gneiss15/AquariumControl/FeederSimple/Hw/README.DE.md

# FeederSimple – Hardware

[English](README.md)

**Coming soon – unvollständig.** FeederSimple ist der Umbau eines gekauften Futterautomaten. Die Originalsteuerung wird ersetzt; die vorhandene Platine und Mechanik werden weiterverwendet. Bestätigte Signalbelegungen und aktuelle Firmwarevorgaben stehen in der [Projekt-README](../README.DE.md).

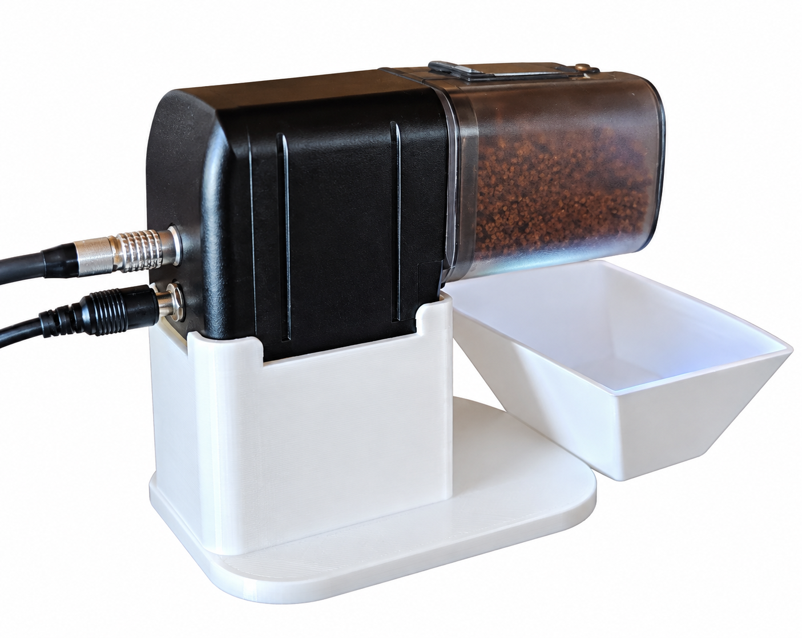
[picture p1: FeederSimple/Hw/Images/FeederComplete.png]
Umgebauter Futterautomat


Noch zu ergänzen: genaue Bezeichnung des Ausgangsgeräts, vollständige Verkabelung, Stückliste, Umbau- und Montageschritte sowie verwendete CAD-/STL-Unterlagen.
