gneiss15/AquariumControl/MultiTimer/Hw/README.DE.md

# MultiTimer / Dashboard – Raspberry-Pi-Hardware

[English](README.md)

**Coming soon – unvollständige Hardwarebeschreibung.** Der vorhandene Aufbau besteht aus einem Raspberry Pi 3 Model B, einer achtfachen Relaiskarte und einem Netzteil im Gehäuse eines Conrad IR-Powermanagers. MultiTimer und Dashboard laufen als getrennte Dienste auf demselben Pi. Ein zusätzlicher Dienst ist für den Raumtemperatur-Sensor vorgesehen; dessen Einbau und Funktionstest stehen noch aus. Der Akku-Sender läuft auf dem Laptop.

## Vorhandene Unterlagen

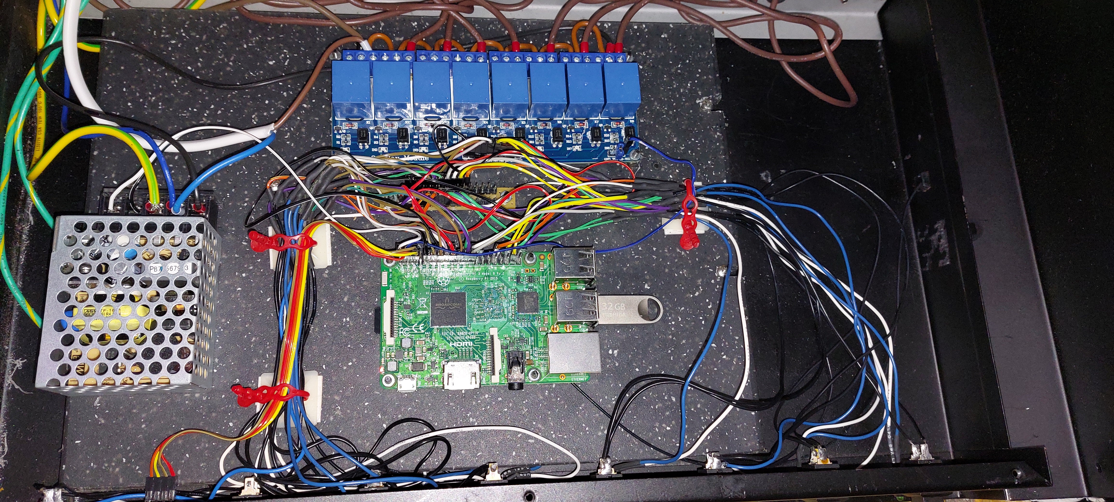
[picture p2: MultiTimer/Hw/Images/20261019_093540.jpg]
Raspberry Pi, relay board and power supply


Weitere Aufnahmen: [20261019_093611](Images/20261019_093611.jpg) · [20261019_093616](Images/20261019_093616.jpg) · [20261019_093928](Images/20261019_093928.jpg) · [20261019_094013](Images/20261019_094013.jpg)

Relaismodul-Unterlage (manufacturer reference; not bundled) · [Sensorplatte (STL)](CAD/SensorPlate.stl) · [Raumtemperatur-Sender](../../RoomTemperature/README.DE.md)

## Noch offen

Vollständige Stückliste mit Netzteil- und Relaiskarten-Typ, Anschlussplan, GPIO-/Kanal-/Steckdosenbelegung und Beschreibung von Einbau und Gehäuse. Die Fotos allein sind keine vollständige Bauanleitung.
