gneiss15/AquariumControl/TmrSwA8T/Hw/README.DE.md

<!-- README.DE.md, Version: 1.00 -->
# TmrSwA8T – Hardware

[English](README.md)

Dieses Projekt verwendet übernommene Nous-A8T-Steckdosen mit eigener Firmware. Die Gerätehardware ist ein Kaufprodukt. Das Verfahren zur Übernahme wird im separaten Projekt [ShellyNousTakeover](https://github.com/gneiss15/ShellyNousTakeover) beschrieben.

## Vorgesehene Ablage

- `Schematics/`: Schaltpläne, Anschluss- und Verdrahtungsunterlagen.
- `PCB/`: Platinenentwürfe und zugehörige Fertigungsdaten, soweit vorhanden.
- `Mechanics/`: CAD-Zeichnungen, Gehäuse- und Bauteilmodelle sowie STL-Dateien.

## Stand der Dokumentation

Die konkreten Dateien und ausführlichen Beschreibungen folgen noch. Bilder,
CAD-Daten, Materiallisten und Baubeschreibungen müssen noch zusammengestellt
bzw. erstellt werden; dies erfordert noch erheblichen Dokumentationsaufwand.
Die angelegten Unterverzeichnisse sind zunächst Platzhalter und bedeuten nicht,
dass für jedes Projekt eigene Platinen oder bereits vollständige Bauunterlagen vorliegen.

Die Hardwareunterlagen bleiben beim jeweiligen Projekt im selben Repository.
Vor Veröffentlichung der konkreten Dateien werden Herkunft und Nutzungsrechte geprüft.
