gneiss15/AquariumControl/TmrSwA8T/Hw/README.md

<!-- README.md, Version: 1.00 -->
# TmrSwA8T – hardware

[Deutsch](README.DE.md)

This project uses converted Nous A8T sockets with custom firmware. The hardware is a purchased product. Initial takeover is described in the separate [ShellyNousTakeover](https://github.com/gneiss15/ShellyNousTakeover) project.

## Directory layout

- `Schematics/`: circuit, connection and wiring documents.
- `PCB/`: PCB designs and manufacturing data, where available.
- `Mechanics/`: CAD drawings, enclosure/component models and STL files.

## Documentation status

Detailed files and descriptions will follow. Images, CAD data, bills of materials and assembly instructions still need to be collected or created. The directories are placeholders; their presence does not imply custom PCBs or complete construction documents.

Hardware documentation is kept with its project in the same repository. Sources and usage rights are checked before specific files are published.
