gneiss15/AquariumControl/FeederSimple/Hw/README.md

# FeederSimple – hardware

[Deutsch](README.DE.md)

**Coming soon – incomplete.** FeederSimple modifies a purchased feeder. The original controller is replaced; the existing PCB and mechanical parts are reused. Tested signal assignments and current firmware settings are documented in the [project README](../README.md).

Modified feeder

Still to document: original device model, complete wiring, bill of materials, modification and assembly steps, and any CAD/STL files used for the conversion.
