gneiss15/AquariumControl/MultiTimer/Hw/Images/20261019_093611.jpg

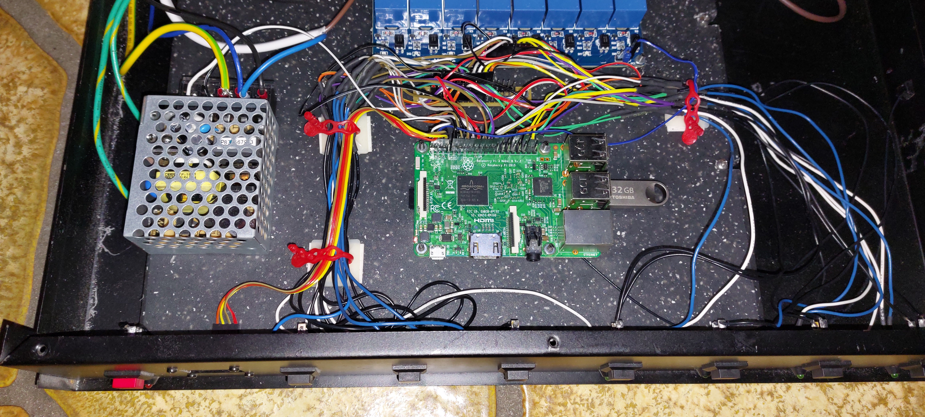
MultiTimer/Hw/Images/20261019_093611.jpg
