gneiss15/AquariumControl/MultiTimer/Hw/Images/20261019_093616.jpg

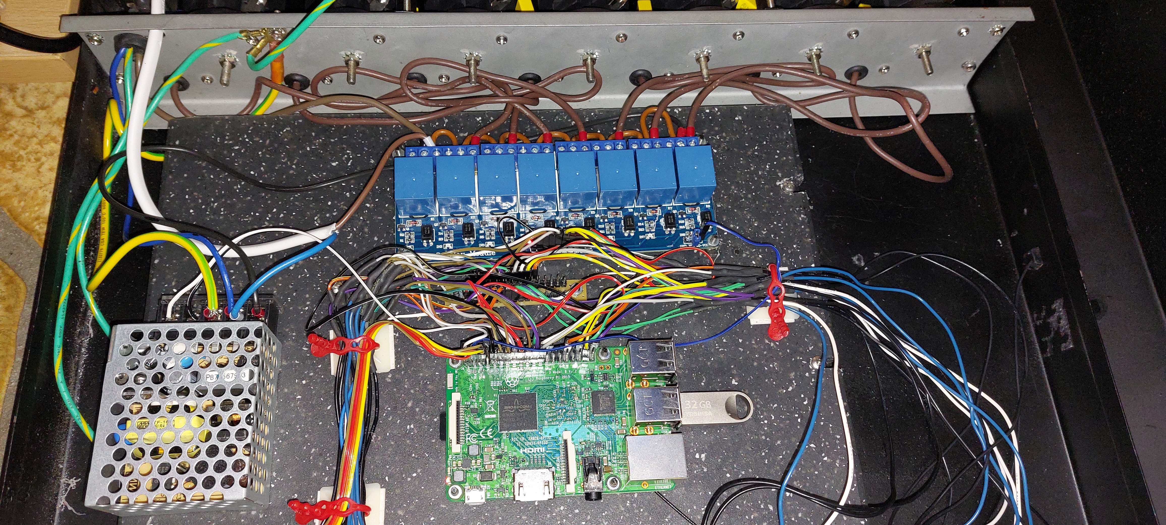
MultiTimer/Hw/Images/20261019_093616.jpg
