gneiss15/AquariumControl/MultiTimer/Hw/Images/20261019_094013.jpg

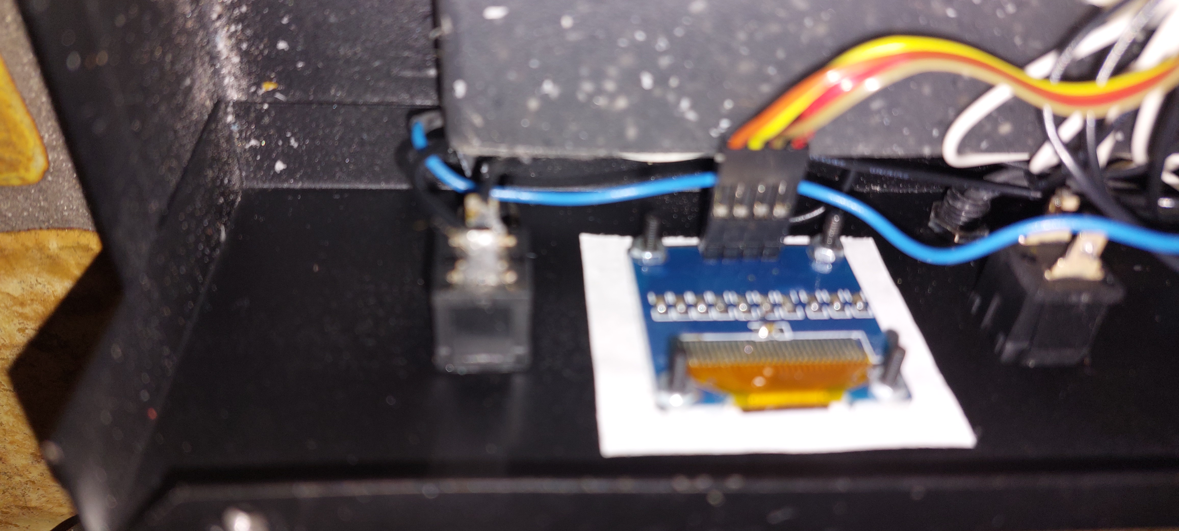
MultiTimer/Hw/Images/20261019_094013.jpg
