gneiss15/AquariumControl/Feeder/Hw/BOM.csv

Position | Quantity | CADLabel | Kind | Standard | Diameter | Length_mm | SourceObjects | AssemblyLinks | Description | Material | Manufacturer | PartNumber | Supplier | OrderURL | Unit | Notes
1 | 1 | CaseBot | Part |  |  |  | Body003004013 | Asm_CaseBot |  |  |  |  |  |  | pcs
2 | 1 | Bot | Part |  |  |  | Body003004011 | Asm_Bot |  |  |  |  |  |  | pcs
3 | 1 | Center | Part |  |  |  | Body | Asm_Center |  |  |  |  |  |  | pcs
4 | 1 | Top | Part |  |  |  | Body003004012 | Asm_Top |  |  |  |  |  |  | pcs
5 | 1 | Lid | Part |  |  |  | Body003004025 | Asm_Lid |  |  |  |  |  |  | pcs
6 | 1 | Funnel | Part |  |  |  | Body003004026 | Asm_Funnel |  |  |  |  |  |  | pcs
7 | 1 | Front | Part |  |  |  | Body003004042 | Asm_Front |  |  |  |  |  |  | pcs
8 | 1 | Food | Part |  |  |  | Body003004039 | Asm_Food |  |  |  |  |  |  | pcs
9 | 1 | WifiKit8 | Assembly |  |  |  | Part006 | Asm_WifiKit8 |  |  |  |  |  |  | pcs
10 | 1 | RotEnc | Assembly |  |  |  | Part007 | Asm_RotEnc |  |  |  |  |  |  | pcs
11 | 1 | DC-Jack | Assembly |  |  |  | Part005 | Asm_DC_Jack |  |  |  |  |  |  | pcs
12 | 1 | ServoPart | Assembly |  |  |  | Part | Asm_ServoPart |  |  |  |  |  |  | pcs
13 | 1 | Lemo-Socket | Assembly |  |  |  | _1 | Asm_Lemo_Socket |  |  |  |  |  |  | pcs
14 | 2 | Screw M2.5 x 5 | Fastener | ISO7045 | M2.5 | 5 | Screw008; Screw009 | Asm_M2_5x5_Screw; Asm_M2_5x5_Screw040 |  |  |  |  |  |  | pcs
15 | 2 | Screw M1.6 x 5 | Fastener | ISO7045 | M1.6 | 5 | Screw010; Screw011 | Asm_M1_6x5_Screw; Asm_M1_6x5_Screw003 |  |  |  |  |  |  | pcs
16 | 4 | Screw M2.5 x 12 | Fastener | ISO7045 | M2.5 | 12 | Screw012; Screw013; Screw014; Screw015 | Asm_M2_5x12_Screw; Asm_M2_5x12_Screw059; Asm_M2_5x12_Screw060; Asm_M2_5x12_Screw061 |  |  |  |  |  |  | pcs
17 | 1 | FrontBridge | Part |  |  |  | Body003004043 | Asm_FrontBridge |  |  |  |  |  |  | pcs
