gneiss15/AquariumControl/Feeder/Hw/CAD/FeederV2-Top.stl

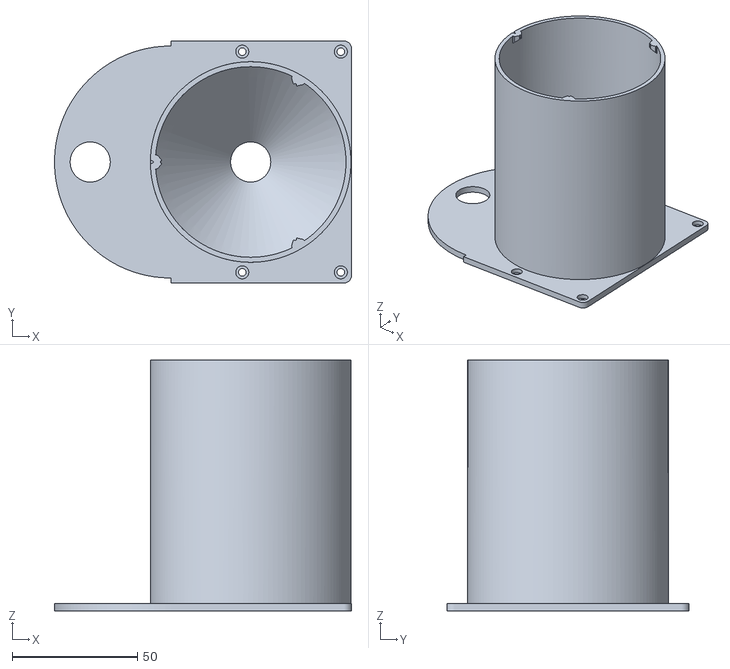
[picture p15: CAD file, 2026-10-21]
Feeder/Hw/CAD/FeederV2-Top.stl
118.4 x 96.5 x 100.0
