gneiss15/AquariumControl/FeederSimple/Hw/CAD/MCU_Holder.FCStd

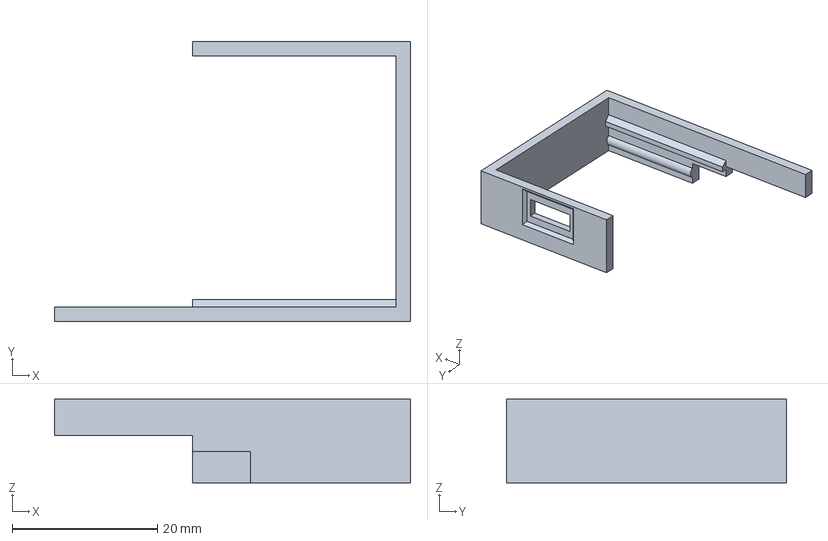
[picture p16: CAD file, 2026-10-20]
FeederSimple/Hw/CAD/MCU_Holder.FCStd
49.0 x 38.5 x 11.5 mm
