gneiss15/AquariumControl/MultiTimer/Hw/CAD/SensorPlate.FCStd

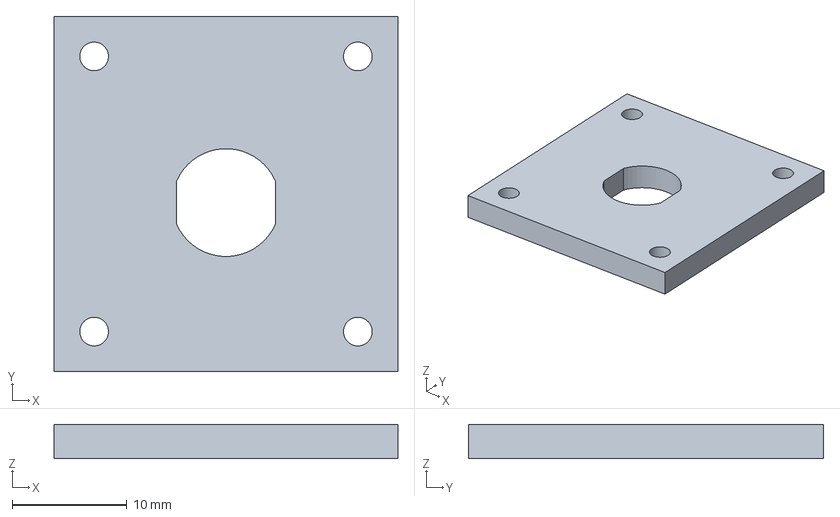
[picture p17: CAD file, 2026-11-11]
MultiTimer/Hw/CAD/SensorPlate.FCStd
30.0 x 31.0 x 3.00 mm
