gneiss15/AquariumControl/Feeder/Hw/CAD/Feeder-Lid.stl

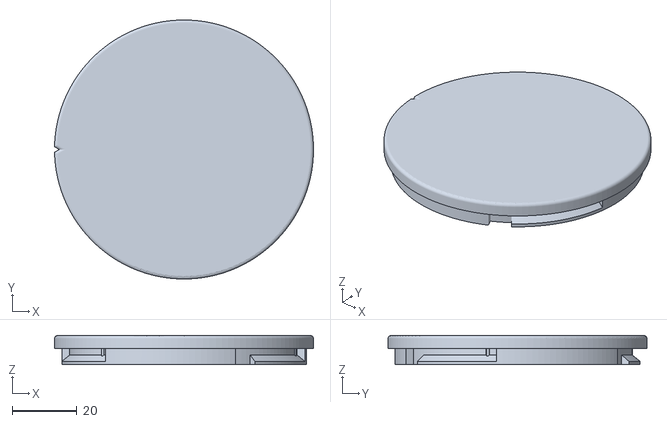
[picture p18: CAD file, 2026-10-21]
Feeder/Hw/CAD/Feeder-Lid.stl
80.0 x 80.0 x 9.00
