gneiss15/AquariumControl/Feeder/Hw/CAD/Feeder-Funnel.stl

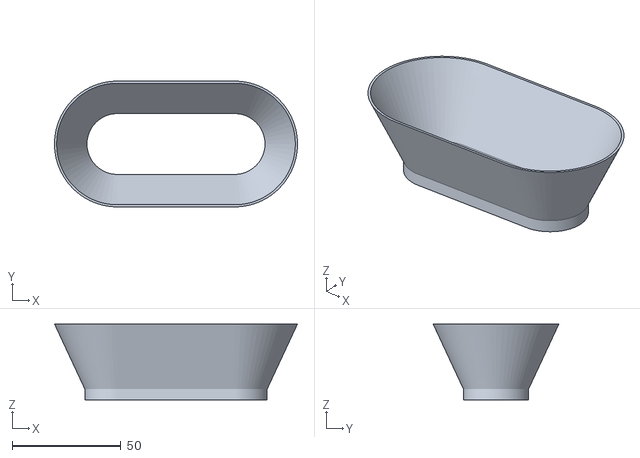
[picture p19: CAD file, 2026-10-21]
Feeder/Hw/CAD/Feeder-Funnel.stl
112.0 x 58.0 x 35.0
