gneiss15/AquariumControl/Feeder/Hw/CAD/Feeder-CaseBot.stl

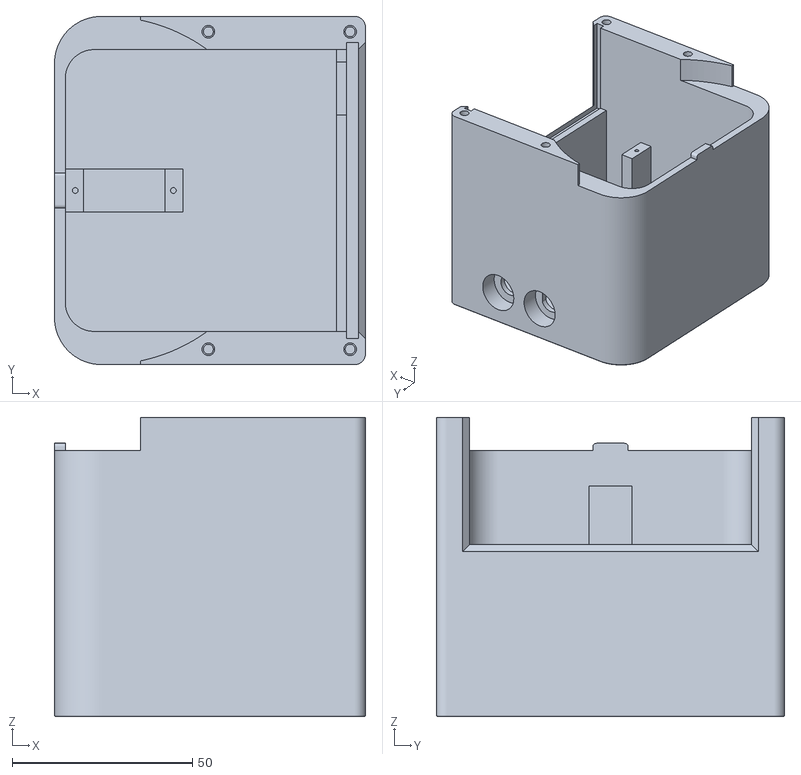
[picture p20: CAD file, 2026-10-21]
Feeder/Hw/CAD/Feeder-CaseBot.stl
86.2 x 96.5 x 83.0
