gneiss15/AquariumControl/Feeder/Hw/CAD/FeederV2.FCStd

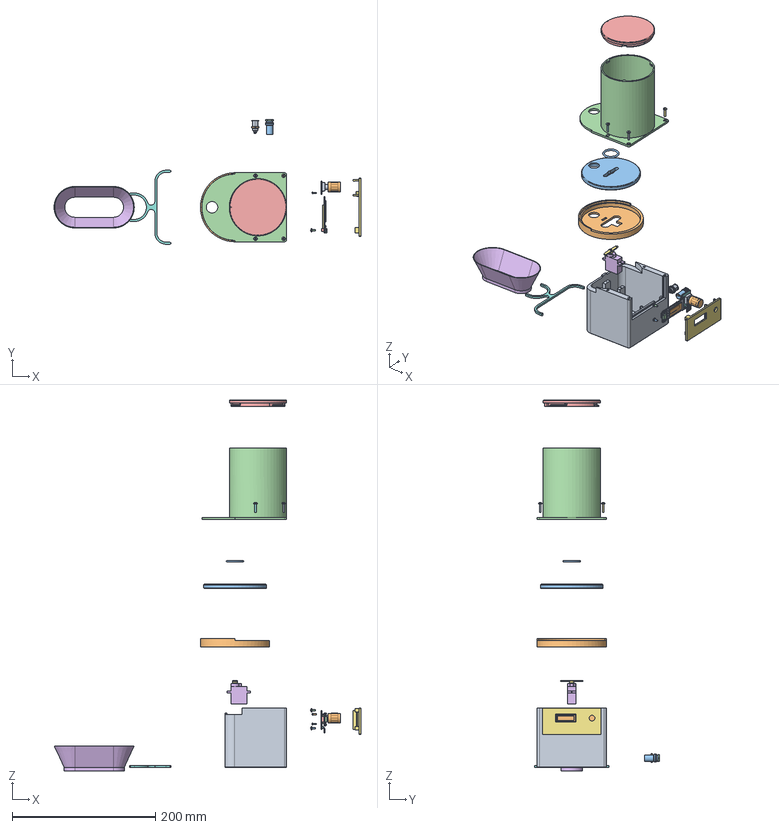
[picture p21: CAD file, 2026-10-21]
Feeder/Hw/CAD/FeederV2.FCStd
428.4 x 174.0 x 518.0 mm
CaseBot
Bot
Center
Top
Lid
Funnel
Front
Food
WifiKit8PCB
WifiKit8OLED
WifiKit8Taster
WifiKit8USB
WifiKit8BAT
WifiKit8IcsTop
WifiKit8IcsBot
RotEncPCB
RotEncBody
RotEncKnob
DC-Jack-Interior
DC-Jack-Nut
DC-Jack-SpringWasher
ServoBody
ServoHorn
ServoPinion
M2.5x5-Screw
M2.5x5-Screw053
M1.6x5-Screw
M2.5x12-Screw
M2.5x12-Screw221
M2.5x12-Screw222
M2.5x12-Screw223
M1.6x5-Screw009
