gneiss15/AquariumControl/Feeder/Hw/CAD/Feeder-Food.stl

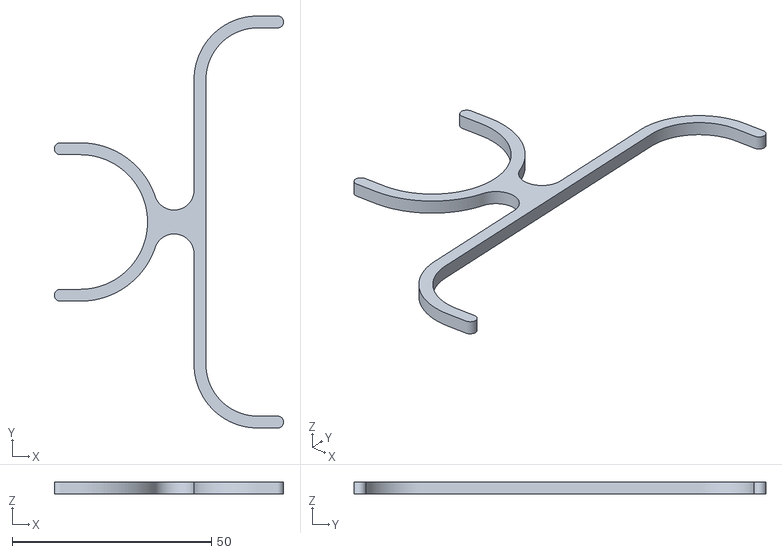
[picture p22: CAD file, 2026-10-21]
Feeder/Hw/CAD/Feeder-Food.stl
57.6 x 103.5 x 3.00
