gneiss15/AquariumControl/Feeder/Hw/CAD/Feeder-Bot.stl

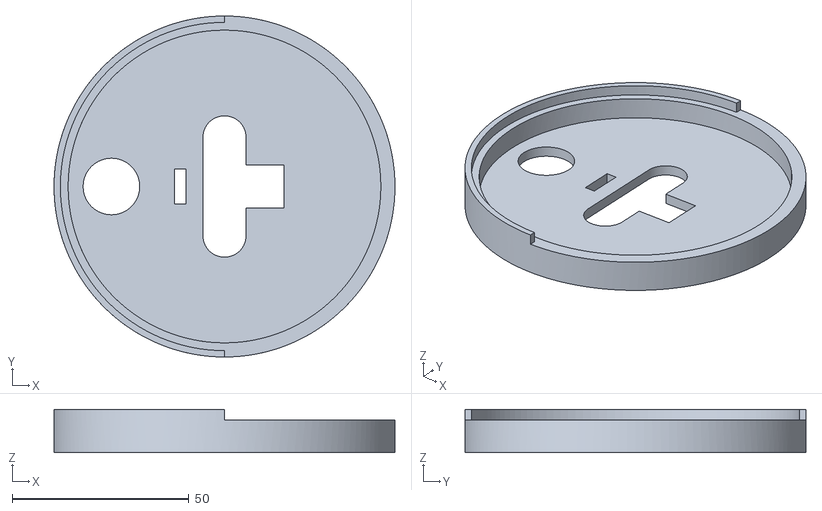
[picture p23: CAD file, 2026-10-21]
Feeder/Hw/CAD/Feeder-Bot.stl
96.5 x 96.5 x 12.2
