gneiss15/AquariumControl/Feeder/Hw/CAD/Feeder.FCStd

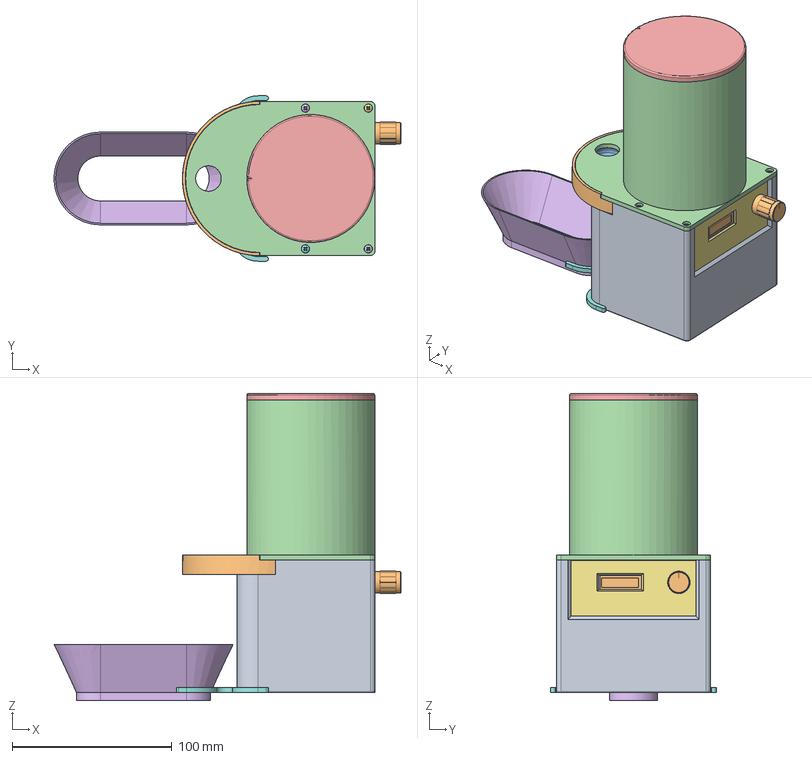
[picture p24: CAD file, 2026-10-21]
Feeder/Hw/CAD/Feeder.FCStd
217.0 x 103.5 x 192.0 mm
CaseBot
Bot
Center
Top
Lid
Funnel
Front
Food
WifiKit8PCB
WifiKit8OLED
WifiKit8Taster
WifiKit8USB
WifiKit8BAT
WifiKit8IcsTop
WifiKit8IcsBot
RotEncPCB
RotEncBody
RotEncKnob
DC-Jack-Interior
DC-Jack-Nut
DC-Jack-SpringWasher
ServoBody
ServoHorn
ServoPinion
M2.5x5-Screw
M2.5x5-Screw051
M1.6x5-Screw
M2.5x12-Screw
M2.5x12-Screw158
M2.5x12-Screw159
M2.5x12-Screw160
M1.6x5-Screw009
FrontBridge
