gneiss15/AquariumControl/Feeder/Hw/CAD/Feeder-Center.stl

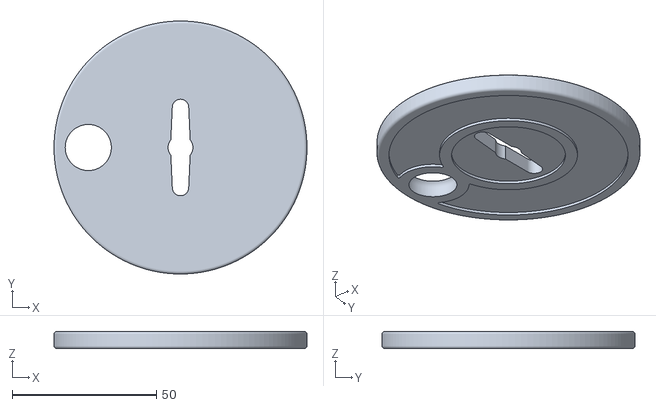
[picture p25: CAD file, 2026-10-21]
Feeder/Hw/CAD/Feeder-Center.stl
87.8 x 87.8 x 6.00
