gneiss15/AquariumControl/Feeder/Hw/CAD/Feeder-Top.stl

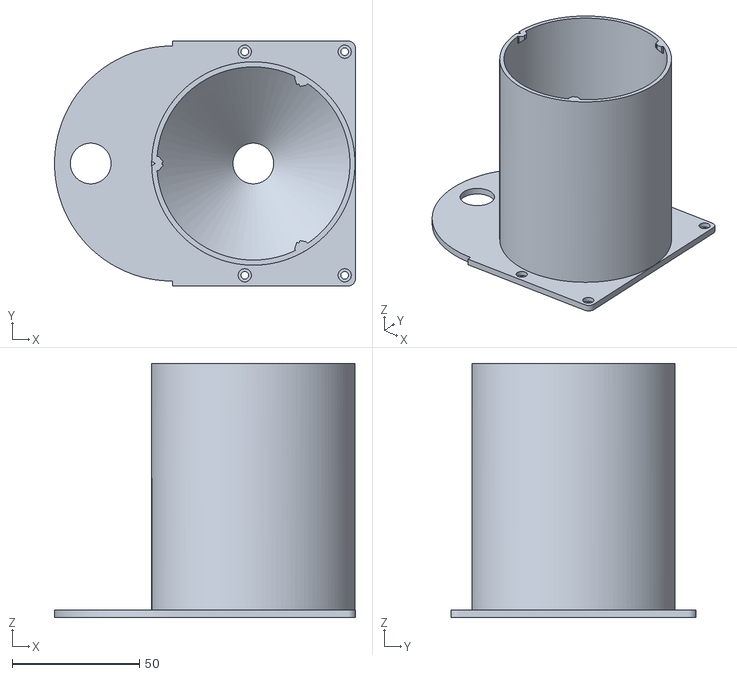
[picture p26: CAD file, 2026-10-21]
Feeder/Hw/CAD/Feeder-Top.stl
118.4 x 96.5 x 100.0
