gneiss15/AquariumControl/Feeder/Hw/CAD/Feeder-Front.stl

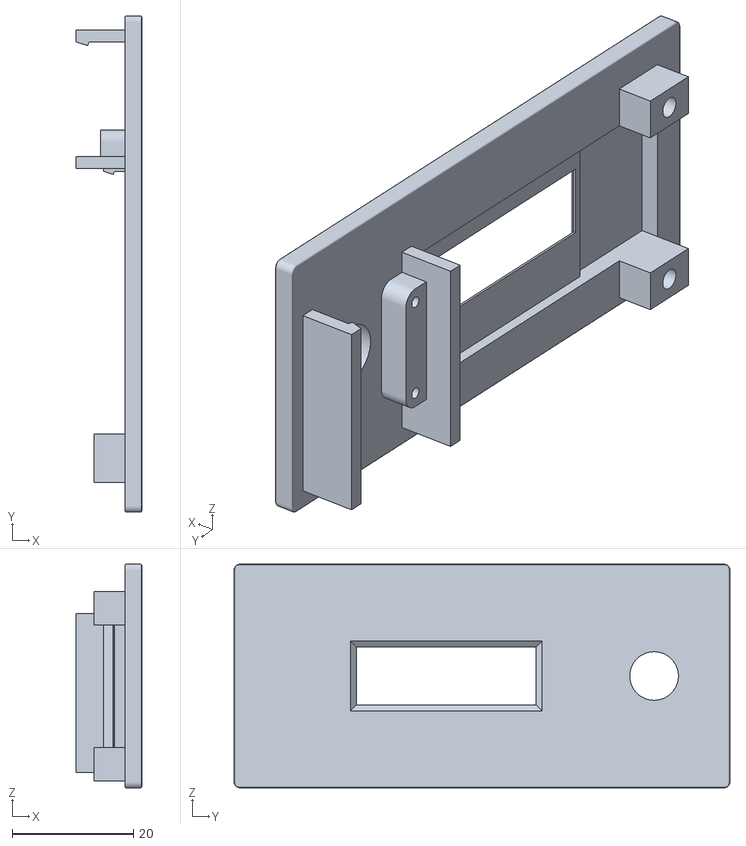
[picture p27: CAD file, 2026-10-20]
Feeder/Hw/CAD/Feeder-Front.stl
10.8 x 81.7 x 36.8
