gneiss15/AquariumControl/Feeder/Hw/CAD/Feeder-FrontBridge.stl

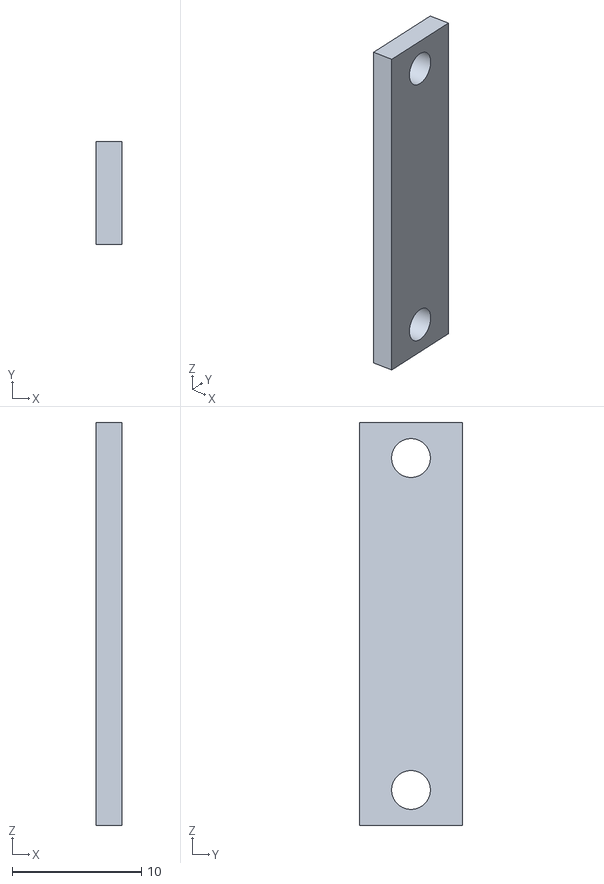
[picture p28: CAD file, 2026-10-20]
Feeder/Hw/CAD/Feeder-FrontBridge.stl
2.00 x 8.00 x 31.2
