gneiss15/AquariumControl/(list of files, cad)

Other CAD files:
FeederSimple/Hw/CAD/MCU_Holder.stl
MultiTimer/Hw/CAD/SensorPlate.3mf
MultiTimer/Hw/CAD/SensorPlate.stl
