gneiss15/AquariumControl/HeatHistory/Charts.html

App ?

# HeatHistory

RangeFromToLoadShow range

Water and Room share one temperature plot. All rows share the UTC time axis. All shows the available retained history, starting with PI activation. Energy totals cover the selected range; measurement gaps remain visible.

PI components explained

Proportional: Kp × (setpoint − water temperature). Integral: accumulated temperature error, limited against windup. Heat-loss estimate: estimated baseline from the heat-loss coefficient and room temperature. Total is the limited demand; Act is delivered power.

The chart library could not be loaded. An internet connection is required.
