gneiss15/AquariumControl/Common/EspRescue/EspRescueHardware.h

// EspRescueHardware.h, Version: 2.00
#pragma once

namespace EspRescueHardware
 {
constexpr int KeyPin = -1;
constexpr int KeyActiveLevel = LOW;
constexpr int StatusLedPin = -1;
constexpr int StatusLedActiveLevel = HIGH;
 }
