gneiss15/AquariumControl/TmrSwShelly/Sw/Rescue/EspRescueHardware.h

// EspRescueHardware.h, Version: 1.01
#pragma once
namespace EspRescueHardware
 {
constexpr int KeyPin = 7;
constexpr int KeyActiveLevel = LOW;
constexpr int StatusLedPin = 18;
constexpr int StatusLedActiveLevel = LOW;
 }
