gneiss15/AquariumControl/Common/EspRescue/EspRescueUpdater.cpp

// EspRescueUpdater.cpp, Version: 2.15
#include "EspRescueUpdater.h"
#include "DeviceType.inc.h"
#include "EspSignedArtifact.h"

#include <cerrno>
#include <cstdio>
#include <esp_err.h>
#include <cstring>
#include <fcntl.h>
#include <sys/time.h>
#include <unistd.h>

#include <esp_system.h>
#include <freertos/FreeRTOS.h>
#include <freertos/task.h>
#include <lwip/inet.h>
#include <lwip/sockets.h>

namespace
 {
  constexpr int HttpTimeoutSeconds = 10;

  bool VerifyWrittenPayload( const esp_partition_t * Partition,
    uint32_t PayloadSize, const uint8_t ExpectedHash[32] )
   {
    TEspSignedArtifactHash Hash;
    Hash.Begin();
    uint8_t Buffer[1024];
    for( uint32_t Offset = 0; Offset < PayloadSize; )
     {
      const size_t Count = PayloadSize - Offset < sizeof( Buffer ) ?
        PayloadSize - Offset : sizeof( Buffer );
      if( esp_partition_read( Partition, Offset, Buffer, Count ) != ESP_OK )
        return false;
      Hash.Add( Buffer, Count );
      Offset += Count;
     }
    return Hash.EndAndCompare( ExpectedHash );
   }

  bool IsContentLengthHeader( char const * Line )
   {
    constexpr char Name[] = "content-length:";
    for( size_t Index = 0; Index < sizeof( Name ) - 1; ++Index )
     {
      char Ch = Line[Index];
      if( Ch >= 'A' && Ch <= 'Z' )
        Ch += 'a' - 'A';
      if( Ch != Name[Index] )
        return false;
     }
    return true;
   }

  bool ParseUInt32( char const * Text, uint32_t & Value )
   {
    while( *Text == ' ' || *Text == '\t' )
      ++Text;
    if( *Text < '0' || *Text > '9' )
      return false;

    uint32_t Result = 0;
    while( *Text >= '0' && *Text <= '9' )
     {
      const uint32_t Digit = uint32_t( *Text - '0' );
      if( Result > (UINT32_MAX - Digit) / 10 )
        return false;
      Result = Result * 10 + Digit;
      ++Text;
     }
    Value = Result;
    return true;
   }

  char const * StatusLine( int Status )
   {
    switch( Status )
     {
      case 200: return "HTTP/1.1 200 OK\r\n";
      case 400: return "HTTP/1.1 400 Bad Request\r\n";
      case 409: return "HTTP/1.1 409 Conflict\r\n";
      case 404: return "HTTP/1.1 404 Not Found\r\n";
      case 411: return "HTTP/1.1 411 Length Required\r\n";
      default:  return "HTTP/1.1 500 Internal Server Error\r\n";
     }
   }
 }

TEspRescueUpdater::TEspRescueUpdater(void)
 : FServerSocket( -1 )
 , FProjectName( "ESP" )
 , FRescueVersion( "?" )
 , FMainPartition( nullptr )
 , FFileSystemPartition( nullptr )
 , FUpdateCompleted( false )
 {
 }

bool TEspRescueUpdater::Setup( char const * ProjectName,
  char const * RescueVersion )
 {
  FProjectName = ProjectName ? ProjectName : "ESP";
  FRescueVersion = RescueVersion ? RescueVersion : "?";
  FMainPartition = esp_partition_find_first(
    ESP_PARTITION_TYPE_APP, ESP_PARTITION_SUBTYPE_APP_OTA_0, nullptr );
  FFileSystemPartition = esp_partition_find_first(
    ESP_PARTITION_TYPE_DATA, ESP_PARTITION_SUBTYPE_DATA_SPIFFS, nullptr );

  // Once Rescue is running it stays the boot target until Commit succeeds.
  RestoreRescueBoot();

  FServerSocket = socket( AF_INET, SOCK_STREAM, IPPROTO_IP );
  if( FServerSocket < 0 )
    return false;

  int ReuseAddress = 1;
  setsockopt( FServerSocket, SOL_SOCKET, SO_REUSEADDR,
    &ReuseAddress, sizeof( ReuseAddress ) );

  sockaddr_in Address = {};
  Address.sin_family = AF_INET;
  Address.sin_port = htons( 80 );
  Address.sin_addr.s_addr = htonl( INADDR_ANY );
  if( bind( FServerSocket, reinterpret_cast<sockaddr *>( &Address ),
            sizeof( Address ) ) != 0 ||
      listen( FServerSocket, 2 ) != 0 )
   {
    close( FServerSocket );
    FServerSocket = -1;
    return false;
   }

  const int Flags = fcntl( FServerSocket, F_GETFL, 0 );
  if( Flags >= 0 )
    fcntl( FServerSocket, F_SETFL, Flags | O_NONBLOCK );
  return true;
 }

bool TEspRescueUpdater::HandleClient( int ClientSocket )
 {
  char Request[96];
  if( !ReadLine( ClientSocket, Request, sizeof( Request ) ) )
    return false;

  char * Path;
  bool IsPost;
  if( strncmp( Request, "GET ", 4 ) == 0 )
   {
    IsPost = false;
    Path = Request + 4;
   }
   else if( strncmp( Request, "POST ", 5 ) == 0 )
   {
    IsPost = true;
    Path = Request + 5;
   }
   else
   {
    SendText( ClientSocket, 400, "Unsupported HTTP method" );
    return false;
   }

  char * End = strchr( Path, ' ' );
  if( !End )
   {
    SendText( ClientSocket, 400, "Invalid HTTP request" );
    return false;
   }
  *End = 0;
  if( char * Query = strchr( Path, '?' ) )
    *Query = 0;

  uint32_t ContentLength = 0;
  if( !ReadHeaders( ClientSocket, ContentLength ) )
   {
    SendText( ClientSocket, 400, "Invalid HTTP headers" );
    return false;
   }

  if( !IsPost && strcmp( Path, "/Progress" ) == 0 )
   {
    SendProgress( ClientSocket );
    return true;
   }

  if( FUploadSocket.load() >= 0 &&
      (IsPost || (strcmp( Path, "/" ) != 0 && strcmp( Path, "/Index.html" ) != 0)) )
   {
    SendText( ClientSocket, 409, "An upload is in progress" );
    return false;
   }

  if( !IsPost && (strcmp( Path, "/" ) == 0 ||
                   strcmp( Path, "/Index.html" ) == 0) )
   {
    SendRecoveryPage( ClientSocket );
    return true;
   }

  if( IsPost && strcmp( Path, "/Firmware" ) == 0 )
    return StartUpload( ClientSocket, TPart::Firmware, ContentLength );
  if( IsPost && strcmp( Path, "/Filesystem" ) == 0 )
    return StartUpload( ClientSocket, TPart::FileSystem, ContentLength );
  if( IsPost && strcmp( Path, "/Commit" ) == 0 )
   {
    FUpdateRequest = true;
    HandleCommit( ClientSocket );
    return true;
   }
  if( IsPost && strcmp( Path, "/Main" ) == 0 )
   {
    FUpdateRequest = true;
    HandleMain( ClientSocket );
    return true;
   }

  SendText( ClientSocket, 404, "Not found" );
  return false;
 }

bool TEspRescueUpdater::StartUpload( int ClientSocket, TPart Part, uint32_t ContentLength )
 {
  FUploadPart = Part;
  FUploadLength = ContentLength;
  FUploadSocket.store( ClientSocket );
  if( xTaskCreate( UploadTask, "RescueUpload", 8192, this, tskIDLE_PRIORITY + 1, nullptr ) != pdPASS )
   {
    FUploadSocket.store( -1 );
    FUpdateRequest = true;
    SendText( ClientSocket, 500, "Could not start upload task" );
    return false;
   }
  FClientTransferred = true;
  return true;
 }

void TEspRescueUpdater::UploadTask( void * Context )
 {
  auto & Updater = *static_cast<TEspRescueUpdater *>( Context );
  const int Socket = Updater.FUploadSocket.load();
  Updater.HandleUpdate( Socket, Updater.FUploadPart, Updater.FUploadLength );
  Updater.FUploadSocket.store( -1 );
  shutdown( Socket, SHUT_RDWR );
  close( Socket );
  vTaskDelete( nullptr );
 }

bool TEspRescueUpdater::HandleUpdate( int ClientSocket,
  TPart Part, uint32_t ContentLength )
 {
  FUpdateCompleted = false;
  portENTER_CRITICAL( &FProgressLock );
  FLastError[0] = 0;
  FWritten = 0;
  FTotal = 0;
  FPhase = Part == TPart::Firmware ? "Main: signed header" : "LittleFS: signed header";
  portEXIT_CRITICAL( &FProgressLock );
  constexpr size_t FixedPrefixSize = 64 + 48;
  constexpr size_t MaximumSignatureSize = 512;
  uint8_t Prefix[FixedPrefixSize + MaximumSignatureSize];
  if( ContentLength < FixedPrefixSize ||
      !ReadExact( ClientSocket, Prefix, FixedPrefixSize ) )
   {
    SendText( ClientSocket, ContentLength ? 400 : 411,
      "Signed artifact header is incomplete" );
    return false;
   }

  uint16_t SignatureSize = 0;
  String Error;
  if( !EspSignedArtifactReadSignatureSize( Prefix, FixedPrefixSize,
       SignatureSize, Error ) || SignatureSize > MaximumSignatureSize )
   {
    SendText( ClientSocket, 400, Error.length() ? Error.c_str() :
      "RSA signature is too large" );
    return false;
   }
  if( !ReadExact( ClientSocket, Prefix + FixedPrefixSize, SignatureSize ) )
   {
    SendText( ClientSocket, 400, "RSA signature is incomplete" );
    return false;
   }

  const uint32_t MaximumPayloadSize = Part == TPart::Firmware ?
    (FMainPartition ? FMainPartition->size : 0) :
    (FFileSystemPartition ? FFileSystemPartition->size : 0);
  SetPhase( "Checking signature and target" );
  TEspSignedArtifactInfo Info = {};
  if( !EspSignedArtifactVerifyPrefix( Prefix, FixedPrefixSize + SignatureSize,
       Part == TPart::Firmware ? TEspSignedArtifactType::Firmware :
         TEspSignedArtifactType::FileSystem,
       ESP_UPDATE_DEVICE_TYPE, ContentLength, MaximumPayloadSize, Info, Error ) )
   {
    SendText( ClientSocket, 400, Error.c_str() );
    return false;
   }

  const bool Firmware = Part == TPart::Firmware;
  bool & WriteUnverified = Firmware ? FMainWriteUnverified : FFileSystemWriteUnverified;
  portENTER_CRITICAL( &FProgressLock );
  FTotal = Info.PayloadSize;
  portEXIT_CRITICAL( &FProgressLock );
  WriteUnverified = true;
  const bool Written = Firmware ?
    HandleFirmware( ClientSocket, Info.PayloadSize, Info.PayloadHash ) :
    HandleFileSystem( ClientSocket, Info.PayloadSize, Info.PayloadHash );
  if( !Written )
    return false;
  SetPhase( "Verifying flash readback" );
  if( !VerifyWrittenPayload( Firmware ? FMainPartition : FFileSystemPartition,
        Info.PayloadSize, Info.PayloadHash ) )
   {
    SendText( ClientSocket, 500, Firmware ?
      "Firmware flash readback mismatch" : "Filesystem flash readback mismatch" );
    return false;
   }

  WriteUnverified = false;
  FUpdateCompleted = true;
  SetPhase( "Upload verified" );
  SendText( ClientSocket, 200, "OK" );
  return true;
 }

bool TEspRescueUpdater::HandleFirmware( int ClientSocket,
  uint32_t PayloadSize, uint8_t const ExpectedHash[32] )
 {
  if( !FMainPartition || PayloadSize > FMainPartition->size )
   {
    SendText( ClientSocket, 500, "Main application partition is missing or too small" );
    return false;
   }

  esp_ota_handle_t OtaHandle = 0;
  SetPhase( "Preparing Main flash" );
  if( const auto Error = esp_ota_begin( FMainPartition, PayloadSize, &OtaHandle ); Error != ESP_OK )
   {
    SendEspError( ClientSocket, "Could not start firmware update", Error );
    return false;
   }

  TEspSignedArtifactHash Hash;
  Hash.Begin();
  uint8_t Buffer[1024];
  SetPhase( "Receiving and writing Main" );
  uint32_t Remaining = PayloadSize;
  while( Remaining )
   {
    const size_t Wanted = Remaining < sizeof( Buffer ) ? Remaining : sizeof( Buffer );
    if( !ReadExact( ClientSocket, Buffer, Wanted ) )
     {
      esp_ota_abort( OtaHandle );
      SendText( ClientSocket, 400, "Firmware payload is incomplete" );
      return false;
     }
    Hash.Add( Buffer, Wanted );
    if( const auto Error = esp_ota_write( OtaHandle, Buffer, Wanted ); Error != ESP_OK )
     {
      esp_ota_abort( OtaHandle );
      SendEspError( ClientSocket, "Could not write firmware", Error );
      return false;
     }
    Remaining -= Wanted;
    SetWritten( PayloadSize - Remaining );
   }

  if( !Hash.EndAndCompare( ExpectedHash ) )
   {
    esp_ota_abort( OtaHandle );
    SendText( ClientSocket, 400, "Firmware payload hash mismatch" );
    return false;
   }
  SetPhase( "Validating Main image" );
  if( const auto Error = esp_ota_end( OtaHandle ); Error != ESP_OK )
   {
    SendEspError( ClientSocket, "Firmware image is invalid", Error );
    return false;
   }
  RestoreRescueBoot();
  return true;
 }

bool TEspRescueUpdater::HandleFileSystem( int ClientSocket,
  uint32_t PayloadSize, uint8_t const ExpectedHash[32] )
 {
  if( !FFileSystemPartition || PayloadSize > FFileSystemPartition->size )
   {
    SendText( ClientSocket, 500, "Filesystem partition is missing or too small" );
    return false;
   }

  SetPhase( "Erasing LittleFS" );
  if( const auto Error = esp_partition_erase_range( FFileSystemPartition, 0,
        FFileSystemPartition->size ); Error != ESP_OK )
   {
    SendEspError( ClientSocket, "Could not erase filesystem partition", Error );
    return false;
   }

  TEspSignedArtifactHash Hash;
  Hash.Begin();
  uint8_t Buffer[1024];
  SetPhase( "Receiving and writing LittleFS" );
  uint32_t Remaining = PayloadSize;
  size_t Offset = 0;
  while( Remaining )
   {
    const size_t Wanted = Remaining < sizeof( Buffer ) ? Remaining : sizeof( Buffer );
    if( !ReadExact( ClientSocket, Buffer, Wanted ) )
     {
      SendText( ClientSocket, 400, "Filesystem payload is incomplete" );
      return false;
     }
    Hash.Add( Buffer, Wanted );
    if( const auto Error = esp_partition_write( FFileSystemPartition, Offset,
                             Buffer, Wanted ); Error != ESP_OK )
     {
      SendEspError( ClientSocket, "Could not write filesystem", Error );
      return false;
     }
    Offset += Wanted;
    Remaining -= Wanted;
    SetWritten( PayloadSize - Remaining );
   }
  if( !Hash.EndAndCompare( ExpectedHash ) )
   {
    SendText( ClientSocket, 400, "Filesystem payload hash mismatch" );
    return false;
   }
  return true;
 }

void TEspRescueUpdater::HandleCommit( int ClientSocket )
 {
  if( !FUpdateCompleted )
   {
    SendText( ClientSocket, 400, "No successful update uploaded" );
    return;
   }
  HandleMain( ClientSocket );
 }

void TEspRescueUpdater::HandleMain( int ClientSocket )
 {
  if( FMainWriteUnverified || FFileSystemWriteUnverified )
   {
    SendText( ClientSocket, 409, "Retry and verify the failed upload before starting Main" );
    return;
   }
  if( !FMainPartition )
   {
    SendText( ClientSocket, 500, "Main application partition app0 was not found" );
    return;
   }
  SetPhase( "Selecting Main boot partition" );
  if( const auto Error = esp_ota_set_boot_partition( FMainPartition ); Error != ESP_OK )
   {
    RestoreRescueBoot();
    SendEspError( ClientSocket, "Could not select main application for next boot", Error );
    return;
   }

  SetPhase( "Starting Main" );
  SendText( ClientSocket, 200, "Starting main application..." );
  vTaskDelay( pdMS_TO_TICKS( 100 ) );
  shutdown( ClientSocket, SHUT_RDWR );
  close( ClientSocket );
  vTaskDelay( pdMS_TO_TICKS( 200 ) );
  esp_restart();
 }

void TEspRescueUpdater::Loop(void)
 {
  if( FServerSocket < 0 )
    return;

  sockaddr_storage SourceAddress = {};
  socklen_t SourceAddressLength = sizeof( SourceAddress );
  const int ClientSocket = accept( FServerSocket,
    reinterpret_cast<sockaddr *>( &SourceAddress ), &SourceAddressLength );
  if( ClientSocket < 0 )
    return;

  timeval Timeout = {};
  Timeout.tv_sec = HttpTimeoutSeconds;
  setsockopt( ClientSocket, SOL_SOCKET, SO_RCVTIMEO, &Timeout, sizeof( Timeout ) );
  setsockopt( ClientSocket, SOL_SOCKET, SO_SNDTIMEO, &Timeout, sizeof( Timeout ) );

  FUpdateRequest = false;
  FClientTransferred = false;
  HandleClient( ClientSocket );
  if( FClientTransferred )
    return;
  shutdown( ClientSocket, SHUT_RDWR );
  close( ClientSocket );
 }

bool TEspRescueUpdater::ReadHeaders( int ClientSocket,
  uint32_t & ContentLength )
 {
  char Line[96];
  ContentLength = 0;
  while( true )
   {
    if( !ReadLine( ClientSocket, Line, sizeof( Line ), true ) )
      return false;
    if( !Line[0] )
      return true;

    if( IsContentLengthHeader( Line ) )
     {
      uint32_t Value;
      if( !ParseUInt32( Line + sizeof( "content-length:" ) - 1, Value ) )
        return false;
      ContentLength = Value;
     }
   }
 }

bool TEspRescueUpdater::ReadLine( int ClientSocket, char * Buffer,
  size_t BufferSize, bool DiscardOverflow )
 {
  size_t Length = 0;
  while( true )
   {
    char Ch;
    const int Count = recv( ClientSocket, &Ch, 1, 0 );
    if( Count == 0 )
      return false;
    if( Count < 0 )
     {
      if( errno == EINTR )
        continue;
      return false;
     }
    if( Ch == '\n' )
     {
      if( Length && Buffer[Length - 1] == '\r' )
        --Length;
      Buffer[Length] = 0;
      return true;
     }
    if( Length + 1 >= BufferSize )
     {
      if( !DiscardOverflow )
        return false;
      continue;
     }
    Buffer[Length++] = Ch;
   }
 }

bool TEspRescueUpdater::ReadExact( int ClientSocket, uint8_t * Buffer,
  size_t Size )
 {
  size_t Done = 0;
  while( Done < Size )
   {
    const int Count = recv( ClientSocket, Buffer + Done, Size - Done, 0 );
    if( Count == 0 )
      return false;
    if( Count < 0 )
     {
      if( errno == EINTR )
        continue;
      return false;
     }
    Done += size_t( Count );
   }
  return true;
 }

bool TEspRescueUpdater::SendAll( int ClientSocket, char const * Text )
 {
  return SendAll( ClientSocket, Text, strlen( Text ) );
 }

bool TEspRescueUpdater::SendAll( int ClientSocket, void const * Data,
  size_t Size )
 {
  size_t Done = 0;
  uint8_t const * Bytes = static_cast<uint8_t const *>( Data );
  while( Done < Size )
   {
    const int Count = send( ClientSocket, Bytes + Done, Size - Done, 0 );
    if( Count < 0 )
     {
      if( errno == EINTR )
        continue;
      return false;
     }
    if( Count == 0 )
      return false;
    Done += size_t( Count );
   }
  return true;
 }

void TEspRescueUpdater::RestoreRescueBoot(void)
 {
  esp_partition_t const * RunningPartition = esp_ota_get_running_partition();
  if( RunningPartition )
    esp_ota_set_boot_partition( RunningPartition );
 }

void TEspRescueUpdater::SendRecoveryPage( int ClientSocket )
 {
  static char const PageStart[] =
    "HTTP/1.1 200 OK\r\n"
    "Connection: close\r\n"
    "Content-Type: text/html; charset=utf-8\r\n\r\n"
    "<!doctype html><html><head><meta charset='utf-8'>"
    "<meta name='viewport' content='width=device-width,initial-scale=1'>"
    "<title>Rescue</title><style>.f{display:flex;align-items:center;gap:.5em;margin:.8em 0;}.f label{flex:0 0 7em}.f input{flex:1 1 auto;min-width:0;width:100%;box-sizing:border-box}</style></head><body><h1>";
  static char const PageMiddle[] =
    " Rescue</h1><p>Version Rescue ";
  static char const PageEnd[] =
    "</p><p><strong>Hw-Typ:</strong> " ESP_UPDATE_DEVICE_TYPE "</p>"
    "<div class='f'><label for='fw'>Firmware:</label><input id='fw' type='file' accept='.bin_signed'></div>"
    "<div class='f'><label for='fs'>Filesystem:</label><input id='fs' type='file' accept='.littlefs_signed'></div>"
    "<button onclick='go()'>Update</button> "
    "<button onclick='mainApp()'>Start Main</button><p id='s'></p><p id='p' role='status'></p><p><a href=/Progress>Rescue progress</a></p>"
    "<script>"
    "function up(p,f,s){return new Promise((ok,fail)=>{"
    "let x=new XMLHttpRequest();x.open('POST',p);"
    "x.upload.onprogress=e=>s.textContent=p+' · '+e.loaded+' / '+f.size+' bytes sent';"
    "x.upload.onload=()=>s.textContent=p+' · waiting for flash verification';"
    "x.onload=()=>x.status===200?ok():fail(Error(x.responseText));"
    "x.onerror=()=>fail(Error('Connection lost'));x.send(f);});}"
    "async function progress(){let p=document.getElementById('p');"
    "try{let r=await probe('/Progress');if(r.ok)p.textContent=await r.text();}catch(_){}"
    "finally{setTimeout(progress,500);}}setTimeout(progress,0);"
    "async function report(s,e){s.textContent=e.message;}"
    "async function go(){let s=document.getElementById('s'),"
    "f=document.getElementById('fw').files[0],"
    "x=document.getElementById('fs').files[0];"
    "if(!f&&!x){s.textContent='Select firmware and/or filesystem';return;}"
    "try{s.textContent='Updating...';if(f)await up('/Firmware',f,s);"
    "if(x)await up('/Filesystem',x,s);"
    "let r=await fetch('/Commit',{method:'POST'}),t=await r.text();"
    "if(!r.ok)throw Error(t);await waitMain(s,Date.now());}"
    "catch(e){await report(s,e);}}"
    "async function probe(u){let c=new AbortController(),x=setTimeout(()=>c.abort(),1500);"
    "try{return await fetch(u,{cache:'no-store',signal:c.signal});}finally{clearTimeout(x);}}"
    "async function waitMain(s,b){let n=0,r;"
    "while(Date.now()-b<120000){n++;s.textContent='Waiting for Main · Versuch '+n+' · '+Math.floor((Date.now()-b)/1000)+' s · '+(n&1?'●':'○');"
    "try{r=await probe('/api/v1/device?MainProbe='+Date.now());if(r.ok){location.replace('/Index.html?Updated='+Date.now());return;}}catch(e){}"
    "await new Promise(q=>setTimeout(q,750));}"
    "throw Error('Main did not become reachable within 120 seconds');}"
    "async function mainApp(){let s=document.getElementById('s');"
    "try{s.textContent='Starting main application...';"
    "let r=await fetch('/Main',{method:'POST'}),t=await r.text();if(!r.ok)throw Error(t);"
    "await waitMain(s,Date.now());}"
    "catch(e){await report(s,e);}}"
    "</script></body></html>";

  SendAll( ClientSocket, PageStart );
  SendAll( ClientSocket, FProjectName );
  SendAll( ClientSocket, PageMiddle );
  SendAll( ClientSocket, FRescueVersion );
  SendAll( ClientSocket, PageEnd );
 }

void TEspRescueUpdater::SetPhase( const char * Phase )
 {
  portENTER_CRITICAL( &FProgressLock );
  FPhase = Phase;
  portEXIT_CRITICAL( &FProgressLock );
 }

void TEspRescueUpdater::SetWritten( uint32_t Written )
 {
  portENTER_CRITICAL( &FProgressLock );
  FWritten = Written;
  portEXIT_CRITICAL( &FProgressLock );
 }

void TEspRescueUpdater::SendProgress( int ClientSocket )
 {
  const char * Phase;
  uint32_t Written, Total;
  char Error[sizeof( FLastError )];
  portENTER_CRITICAL( &FProgressLock );
  Phase = FPhase;
  Written = FWritten;
  Total = FTotal;
  memcpy( Error, FLastError, sizeof( Error ) );
  portEXIT_CRITICAL( &FProgressLock );

  char Text[256];
  snprintf( Text, sizeof( Text ), "%s · %lu / %lu bytes written%s%s",
    Phase, (unsigned long) Written, (unsigned long) Total, Error[0] ? " · " : "", Error );
  SendText( ClientSocket, 200, Text );
 }

void TEspRescueUpdater::SendEspError( int ClientSocket, const char * Text, esp_err_t Error )
 {
  char Detail[160];
  snprintf( Detail, sizeof( Detail ), "%s: %s (0x%X)", Text, esp_err_to_name( Error ), unsigned( Error ) );
  SendText( ClientSocket, 500, Detail );
 }

void TEspRescueUpdater::SendText( int ClientSocket, int Status,
  char const * Text )
 {
  if( Status >= 400 && (ClientSocket == FUploadSocket.load() || FUpdateRequest) )
   {
    const size_t Length = strnlen( Text, sizeof( FLastError ) - 1 );
    portENTER_CRITICAL( &FProgressLock );
    memcpy( FLastError, Text, Length );
    FLastError[Length] = 0;
    portEXIT_CRITICAL( &FProgressLock );
   }
  SendAll( ClientSocket, StatusLine( Status ) );
  SendAll( ClientSocket,
    "Connection: close\r\nContent-Type: text/plain; charset=utf-8\r\n\r\n" );
  SendAll( ClientSocket, Text );
 }
