gneiss15/AquariumControl/(commit log)

2026-10-20 Publish AquariumControl work in progress with hardware documentation
    [BOM.csv, BOM.ods, ConfigurationTransaction.h, Feeder-Front.stl, Feeder-FrontBridge.stl, Feeder.FCStd, FeederV2.FCStd, MCU_Holder.FCStd]
2026-10-20 Document A8T calibration using a Shelly reference instead of personal results
2026-10-20 Document LEMO sensor pins and pull-up connection in wiring diagrams
2026-10-21 Show assembled feeder and OLED menu photos in hardware READMEs
2026-10-21 Use Aq as the repository root and include revised CAD tolerances
    [BOM.csv, BOM.ods, ConfigurationTransaction.h, Feeder-Bot.stl, Feeder-CaseBot.stl, Feeder-Center.stl, Feeder-Food.stl, Feeder-Front.stl]
2026-10-21 Add English Dashboard documentation and clarify Raspberry Pi hardware
2026-10-21 Explain device identity and function assignment in plain language
2026-10-21 Describe replacement devices as functionally compatible
2026-10-21 Describe current endpoint swapping without implementation history
2026-10-21 Rewrite Dashboard documentation around current operation
2026-10-21 Use consistent Nous spelling in documentation and displayed text
    [partitions.csv]
2026-11-06 Save current aquarium single-source development state
    [ConfigurationTransaction.h, SensorPlate.3mf, SensorPlate.FCStd, SensorPlate.stl]
2026-11-11 Stabilize feeder measurements and UDP status
    [Feeder.ino, FeederSimple.ino]
